maxgrim/RedTreat2023Badge/README.md

# RedTreat 2023 badge

- [Software](./Software/redtreat2023/)
- [Hardware](./KiCad/)
- [Presentation](./Presentation.pdf)
- [How to fix](./HOWTOFIX.md)

RedTreat 2023 badge
