maxgrim/RedTreat2023Badge/KiCad/README.md

# Gerbolyze
```
gerbolyze template production/gerbers --top test.svg
gerbolyze paste production/gerbers test.svg production/gerbers-art
```
