maxgrim/RedTreat2023Badge/KiCad/Badge.kicad_pcb

## KiCad design KiCad/Badge.kicad_pcb (2023-10-16)

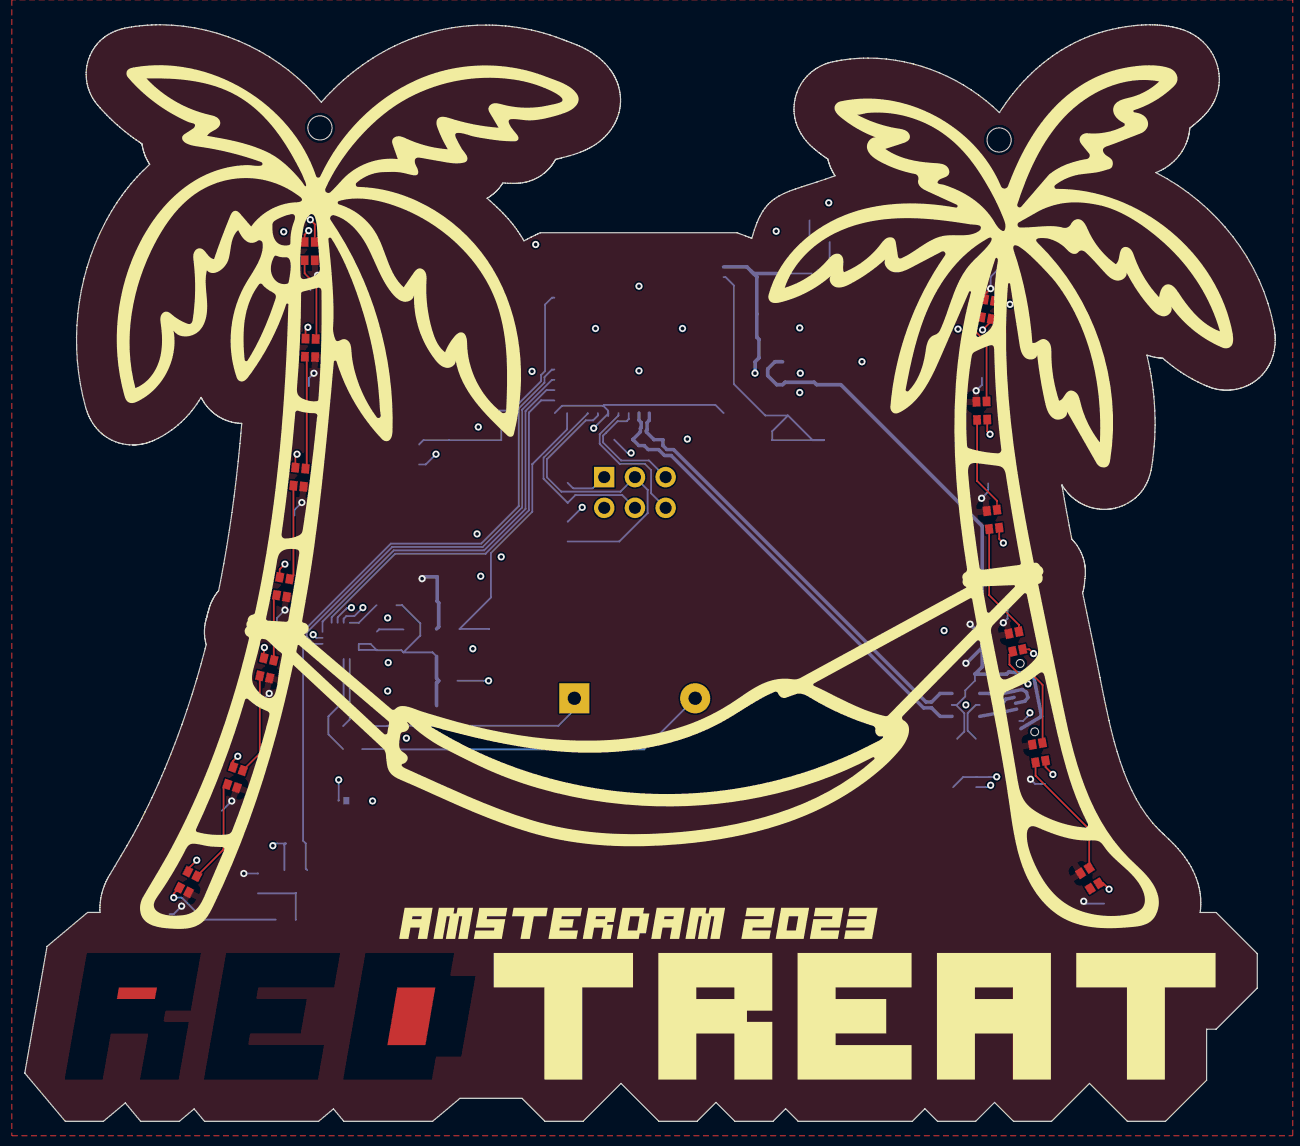
[picture p1: board Badge.kicad_pcb from above]

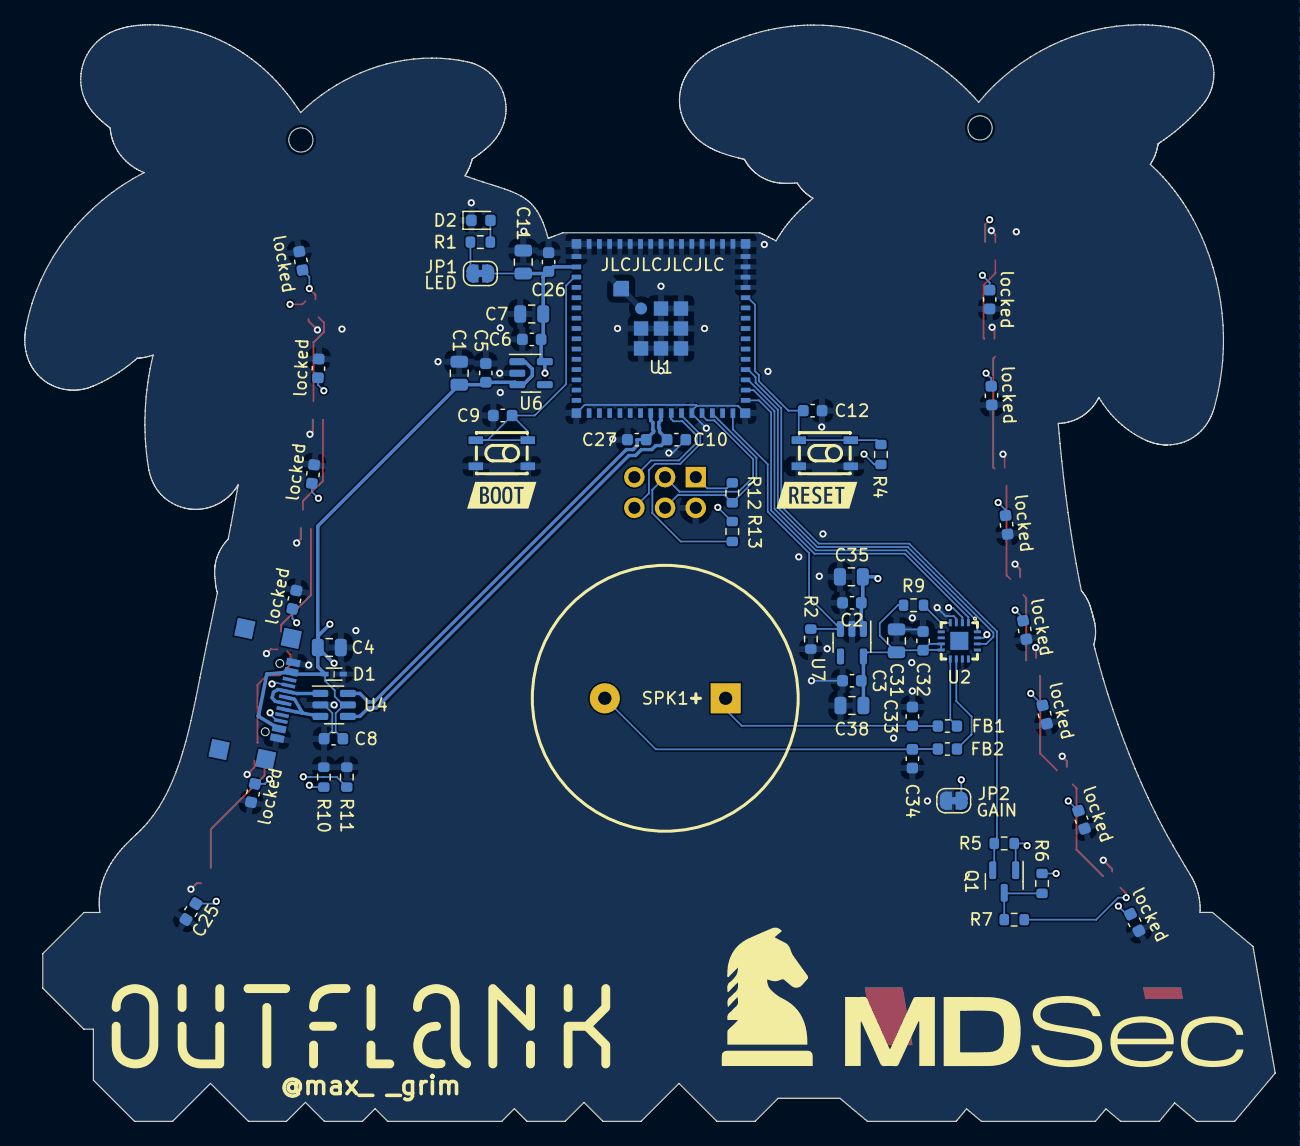
[picture p2: board Badge.kicad_pcb from below]

Board: 4 copper layers, 103.5 x 90.7 mm, 78 parts (62 on the bottom side), 43 nets.

Parts:
C1, C4, C7, C11, C31, C35, C38: 10uF; C_0805_2012Metric
C2, C3, C5, C6: 1uF; C_0603_1608Metric
C8, C9, C25, C26, C32: 100nF; C_0603_1608Metric
C10, C27: 22pF; C_0603_1608Metric
C12: locked; C_0603_1608Metric
C33, C34: 220pF; C_0603_1608Metric
D1: LESD5D5.0CT1G; SOD-523_L1.2-W0.8-LS1.6-BI
D2: RED Power; LED_0603_1608Metric
FB1, FB2: PBY160808T-102Y-N; L_0603_1608Metric
J2: SAO; PinSocket_2x03_P2.54mm_Vertical
JP1: PowerLED; SolderJumper-2_P1.3mm_Bridged_RoundedPad1.0x1.5mm
JP2: GAIN; SolderJumper-2_P1.3mm_Bridged_RoundedPad1.0x1.5mm
LED1, LED2, LED3: locked; LED-SMD_4P-L1.6-W1.5_XL-1615RGBC-WS2812B
LED13: WS2812B; LED-SMD_4P-L1.6-W1.5_XL-1615RGBC-WS2812B
Q1: locked; SOT-23
R1, R10, R11: 5.1K; R_0603_1608Metric
R2, R4, R5, R6, R9: 100K; R_0603_1608Metric
R7: 300; R_0603_1608Metric
R12, R13: 3.3K; R_0603_1608Metric
SPK1: GSPK2307P-8R1W; SPK-TH_BD23.0-P10.00-D0.8-L-RD
SW1: BOOT; SW-SMD_4P-L4.2-W3.4-P2.15-LS5.2
SW2: RESET; SW-SMD_4P-L4.2-W3.4-P2.15-LS5.2
U1: ESP32-MINI-1-N4; WIFI-SMD_ESP32-MINI-1-N4
U2: MAX98357AETE+T; TQFN-16_L3.0-W3.0-P0.50-BL-EP1.5
U4: USBLC6-2SC6; SOT-23-6
U6, U7: XC6220B331MR; SOT-23-5
kibuzzard-64FAFBDA: G***; kibuzzard-64FAFBDA
kibuzzard-64FAFBE9: G***; kibuzzard-64FAFBE9
locked: locked; MountingHole_2mm
locked#2, locked#3, locked#4, locked#5, locked#6, locked#7, locked#8, locked#9, locked#11: locked; LED-SMD_4P-L1.6-W1.5_XL-1615RGBC-WS2812B
locked#10: locked; MountingHole_2mm
locked#12, locked#14, locked#15, locked#16, locked#17, locked#18, locked#19, locked#20, locked#21, locked#22, locked#23, locked#24: locked; C_0603_1608Metric
locked#13: MC-107SSY; USB-TYPE-C-SMD_MC-107SSY

Connections:
+3.3V: C6.1, C7.1, C11.1, C26.1, J2.1, JP1.1 (A), Q1.1 (G), R4.1, R5.1, R12.1, R13.1, U1.2 (3V3), U6.5 (VOUT)
+3.3VA: C3.1, C31.1, C32.1, C38.1, R9.1, U2.7 (VDD), U2.8 (VDD), U7.5 (VOUT)
+5V: C1.1, C2.1, C4.1, C5.1, C8.1, C25.1, C35.1, D1.1, LED1.2 (VDD), LED2.2 (VDD), LED3.2 (VDD), LED13.2 (VDD), R6.1, U4.5 (VBUS), U6.1 (VIN), U6.3 (CE), U7.1 (VIN), locked#2.2 (VDD), locked#3.2 (VDD), locked#4.2 (VDD), locked#5.2 (VDD), locked#6.2 (VDD), locked#7.2 (VDD), locked#8.2 (VDD), locked#9.2 (VDD), locked#11.2 (VDD), locked#12.1, locked#13.A4 (VBUS), locked#13.A9 (VBUS), locked#13.B4 (VBUS), locked#13.B9 (VBUS), locked#14.1, locked#15.1, locked#16.1, locked#17.1, locked#18.1, locked#19.1, locked#20.1, locked#21.1, locked#22.1, locked#23.1, locked#24.1
/AU_EN: R2.1, U1.30 (IO36), U7.3 (CE)
/D+: U4.3 (I/O2), locked#13.A6 (D+), locked#13.B6 (D+)
/D-: U4.1 (I/O1), locked#13.A7 (D-), locked#13.B7 (D-)
/ESP_BOOT: C9.2, SW1.1, U1.3 (IO00)
/ESP_EN: C12.2, R4.2, SW2.1, U1.41 (EN)
/I2C_SCL: J2.4, R12.2, U1.28 (IO34)
/I2C_SDA: J2.3, R13.2, U1.27 (IO33)
/I2S_BCK: U1.32 (IO38), U2.16 (BCLK)
/I2S_DATA: U1.31 (IO37), U2.1 (DIN)
/I2S_WS: U1.33 (IO39), U2.14 (LRCLK)
/RGB: Q1.2 (S), R5.2, U1.34 (IO40)
/SAO_IO1: J2.5, U1.24 (IO21)
/SAO_IO2: J2.6, U1.25 (IO26)
/USB_D+: C10.1, U1.23 (USB_D+), U4.4 (I/O2)
/USB_D-: C27.1, U1.22 (USB_D-), U4.6 (I/O1)
GND: C1.2, C2.2, C3.2, C4.2, C5.2, C6.2, C7.2, C8.2, C9.1, C10.2, C11.2, C12.1, C25.2, C26.2, C27.2, C31.2, C32.2, C33.2, C34.2, C35.2, C38.2, D1.2, D2.1 (K), J2.2, JP2.1 (A), LED1.3 (GND), LED2.3 (GND), LED3.3 (GND), LED13.3 (GND), R2.2, R10.2, R11.2, SW1.2, SW2.2, U1.1 (GND), U1.26 (GND), U1.42 (GND), U1.43 (GND), U1.44 (GND), U1.45 (GND), U1.46 (GND), U1.47 (GND), U1.48 (GND), U1.49 (GND), U1.50 (GND), U1.51 (GND), U1.52 (GND), U1.53 (GND), U1.54 (GND), U1.55 (GND), U1.56 (GND), U1.57 (GND), U1.58 (GND), U1.59 (GND), U1.60 (GND), U1.61 (GND), U1.62 (GND), U1.63 (GND), U1.64 (GND), U1.65 (GND), U2.3 (GND), U2.11 (GND), U2.15 (GND), U4.2 (GND), U6.2 (GND), U7.2 (GND), locked#2.3 (GND), locked#3.3 (GND), locked#4.3 (GND), locked#5.3 (GND), locked#6.3 (GND), locked#7.3 (GND), locked#8.3 (GND), locked#9.3 (GND), locked#11.3 (GND), locked#12.2, locked#13.A1 (GND), locked#13.A12 (GND), locked#13.B1 (GND), locked#13.B12 (GND), locked#14.2, locked#15.2, locked#16.2, locked#17.2, locked#18.2, locked#19.2, locked#20.2, locked#21.2, locked#22.2, locked#23.2, locked#24.2
unnamed: D2.2 (A), R1.2
unnamed: JP1.2 (B), R1.1
unnamed: JP2.2 (B), U2.2 (GAIN_SLOT)
unnamed: LED1.4 (DI), R7.1
unnamed: LED1.1 (DO), LED2.4 (DI)
unnamed: LED2.1 (DO), LED3.4 (DI)
unnamed: LED3.1 (DO), locked#6.4 (DI)
unnamed: locked#6.1 (DO), locked#8.4 (DI)
unnamed: locked#3.4 (DI), locked#8.1 (DO)
unnamed: locked#3.1 (DO), locked#4.4 (DI)
unnamed: locked#4.1 (DO), locked#5.4 (DI)
unnamed: locked#5.1 (DO), locked#11.4 (DI)
unnamed: locked#2.4 (DI), locked#11.1 (DO)
unnamed: locked#2.1 (DO), locked#9.4 (DI)
unnamed: locked#7.4 (DI), locked#9.1 (DO)
unnamed: LED13.4 (DI), locked#7.1 (DO)
unnamed: Q1.3 (D), R6.2, R7.2
unnamed: C33.1, FB1.2, SPK1.1 (+)
unnamed: C34.1, FB2.2, SPK1.2 (-)
unnamed: FB2.1, U2.10 (OUTN)
unnamed: FB1.1, U2.9 (OUTP)
unnamed: R9.2, U2.4 (~SD_MODE)
unnamed: R10.1, locked#13.A5 (CC1)
unnamed: R11.1, locked#13.B5 (CC2)
