maxgrim/RedTreat2023Badge/Software/redtreat2023/main/mqtt.c

#include <esp_log.h>
#include <mqtt_client.h>

static const char *TAG = "redtreat_mqtt";

static struct mqtt_handler_data {
    const char *username;
    void (*message_callback)(char *, int);
    void (*connect_callback)(void);
    void (*disconnect_callback)(void);
    void (*error_callback)(void);
} handler_data;

static void log_error_if_nonzero(const char *message, int error_code) {
    if (error_code != 0) {
        ESP_LOGE(TAG, "Last error %s: 0x%x", message, error_code);
    }
}

static void mqtt_event_handler(void *handler_args, esp_event_base_t base, int32_t event_id, void *event_data) {
    ESP_LOGD(TAG, "Event dispatched from event loop base=%s, event_id=%" PRIi32 "", base, event_id);
    esp_mqtt_event_handle_t event = event_data;
    esp_mqtt_client_handle_t client = event->client;

    int msg_id;

    switch ((esp_mqtt_event_id_t)event_id) {
        case MQTT_EVENT_CONNECTED:
            ESP_LOGI(TAG, "MQTT_EVENT_CONNECTED");

            ESP_LOGI(TAG, "subscribing to %s", handler_data.username);
            msg_id = esp_mqtt_client_subscribe(client, handler_data.username, 0);
            ESP_LOGI(TAG, "sent subscribe successful, msg_id=%d", msg_id);

            handler_data.connect_callback();
            break;
        case MQTT_EVENT_DISCONNECTED:
            ESP_LOGI(TAG, "MQTT_EVENT_DISCONNECTED");
            handler_data.disconnect_callback();
            break;
        case MQTT_EVENT_SUBSCRIBED:
            ESP_LOGI(TAG, "MQTT_EVENT_SUBSCRIBED, msg_id=%d", event->msg_id);
            msg_id = esp_mqtt_client_publish(client, "/topic/qos0", "data", 0, 0, 0);
            ESP_LOGI(TAG, "sent publish successful, msg_id=%d", msg_id);
            break;
        case MQTT_EVENT_UNSUBSCRIBED:
            ESP_LOGI(TAG, "MQTT_EVENT_UNSUBSCRIBED, msg_id=%d", event->msg_id);
            break;
        case MQTT_EVENT_PUBLISHED:
            ESP_LOGI(TAG, "MQTT_EVENT_PUBLISHED, msg_id=%d", event->msg_id);
            break;
        case MQTT_EVENT_DATA:
            ESP_LOGI(TAG, "MQTT_EVENT_DATA");
            ESP_LOGI(TAG, "TOPIC=%.*s\r\n", event->topic_len, event->topic);
            ESP_LOGI(TAG, "DATA=%.*s\r\n", event->data_len, event->data);
            handler_data.message_callback(event->data, event->data_len);
            break;
        case MQTT_EVENT_ERROR:
            ESP_LOGI(TAG, "MQTT_EVENT_ERROR");

            handler_data.error_callback();

            if (event->error_handle->error_type == MQTT_ERROR_TYPE_TCP_TRANSPORT) {
                log_error_if_nonzero("reported from esp-tls", event->error_handle->esp_tls_last_esp_err);
                log_error_if_nonzero("reported from tls stack", event->error_handle->esp_tls_stack_err);
                log_error_if_nonzero("captured as transport's socket errno", event->error_handle->esp_transport_sock_errno);
                ESP_LOGI(TAG, "Last errno string (%s)", strerror(event->error_handle->esp_transport_sock_errno));
            }
            break;
        default:
            ESP_LOGI(TAG, "Other event id:%d", event->event_id);
            break;
    }
}

void mqtt_app_start(const char *username, void (*message_callback)(char *, int), void (*connect_callback)(void), void (*disconnect_callback)(void), void (*error_callback)(void)) {
    const esp_mqtt_client_config_t mqtt_cfg = {
        .broker.address.uri = CONFIG_BROKER_URL,
        .credentials.username = username,
        .credentials.authentication.password = CONFIG_BROKER_PASSWORD};

    esp_mqtt_client_handle_t client = esp_mqtt_client_init(&mqtt_cfg);

    handler_data.username = username;
    handler_data.message_callback = message_callback;
    handler_data.connect_callback = connect_callback;
    handler_data.disconnect_callback = disconnect_callback;
    handler_data.error_callback = error_callback;

    /* The last argument may be used to pass data to the event handler, in this example mqtt_event_handler */
    esp_mqtt_client_register_event(client, ESP_EVENT_ANY_ID, mqtt_event_handler, NULL);
    esp_mqtt_client_start(client);
}
